lucilej/AutonomousLyre/README.md

# Autonomous Lyre
Projet : créer un support permettant de jouer des mélodies sur la lyre grâce à arduino
