lucilej/AutonomousLyre/RapportsSeances/Seance5.md

<h1>Rapport de la séance 5 du 1er fevrier 2023</h1>
<ul>
  <li><p>J'ai collé avec le pistolet à colle des médiators pour guitare sur les "helices" du servomoteur.</p></li>
  mediators collés
  <li><p>J'ai testé si les médiators marchaient bien sur les cordes.</p></li>
  <li><p>J'ai découpé quatres planches en bois : 2 planches qui vont soutenir sur le côté les planches des moteurs, 2 planches qui font des calepins pour pouvoir visser les autres planches.<p></li>
  <li><p>Je les ai assemblées<p></li>
  <li><p>J'ai fait un mini programme censé faire jouer toutes les cordes de la lyre<p></li>
