lucilej/AutonomousLyre/RapportsSeances/Seance1.md

<h1>Rapport de la séance 1 du 14 décembre 2022</h1>
<ul>
  <li><p>J'ai réfléchi sur quel type de support la lyre pourrait tenir, ainsi que les servomoteurs</p></li>
  <li><p>Réalisation d'un schéma illustrant la lyre et le support qui tient les servomoteurs</p></li>
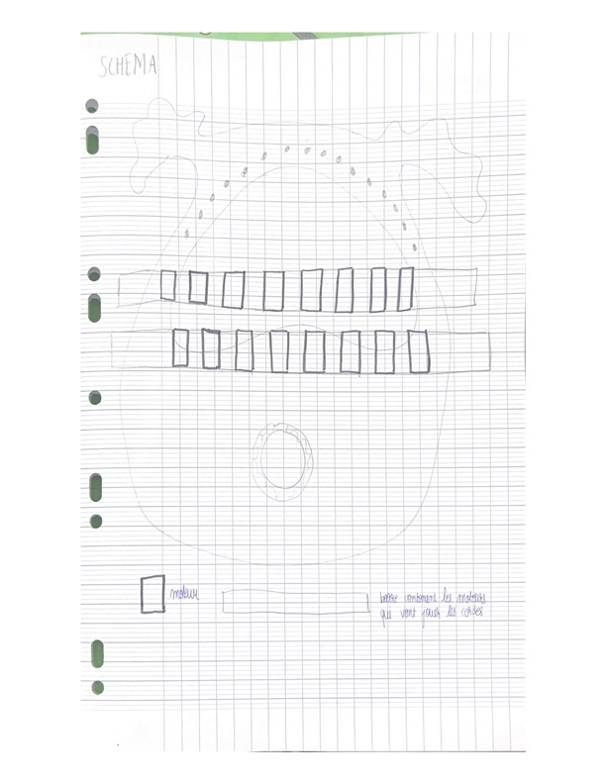
[picture p4: Documents/Images/schemalyre.jpg]
Schema
  
  <li><p>Choix moteur correspondant le mieux au pincement des cordes</p></li>
  <li><p>J'ai lu le cours disponible sur les servomoteurs en faisant un petit montage pour voir comment cela fonctionne</p></li>
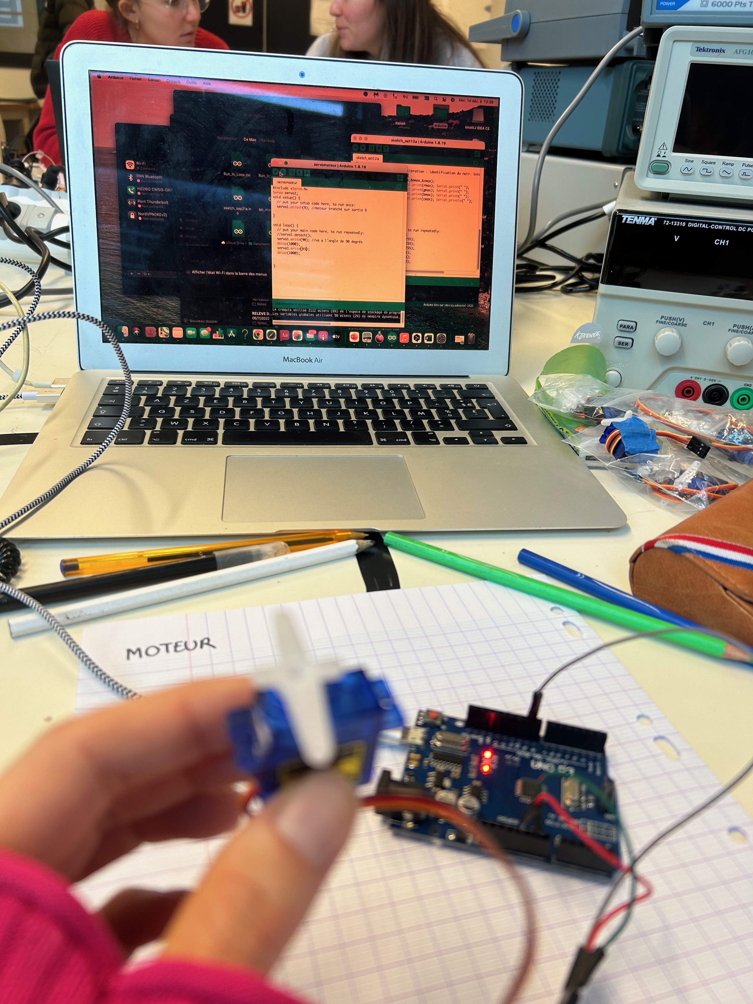
[picture p5: Documents/Images/IMG_0251.jpeg]
Montage d'un servomoteur
