lucilej/AutonomousLyre/Documents/CahierDesCharges.md

<h1>Cahier des charges</h1>
  <ol> 
    <li><p>Contexte et présentation du projet : <p></li>
      <p>Création d'un prototype permettant de jouer de la lyre avec arduino</p>
    <li><p> Besoins et contraintes liés au projet : </p></li>
        <ul>
          <li><p>Contraintes : organiser et comprendre la création du prototype (matériaux, code, assemblage), respecter le planning</p></li>
          <li><p>Besoins : être à l'aise avec les fonctionnalités d'arduino et l'assemblage de pièces</p></li>
        </ul>
    <li><p>Résultats attendus : </p></li>
            <p>Quand on appuie sur un ou des boutons, cela envoie des informations à la carte arduino qui va permettre au moteur de faire fonctionner le prototype en jouant les cordes voulues, et donc la mélodie souhaitée</p>
  </ol>
