lucilej/AutonomousLyre/Documents/PlanningProjet.md

<h1>Planning du projet</h1>
    <h2>Séance 1</h2>
    <ul>
      <li>Imagination d'une maquette pour permettre de mieux se représenter le projet</li>
      <li>Réfléchir sur quelles pièces je pourrais avoir besoin afin de réliser le projet</li>
      <li>Faire un schéma de fonctionnement du projet</li>
      <li>Mieux organiser le github pour les prochaines séances à venir</li>
    </ul>
    <h2>Séance 2</h2>
    <ul>
      <li>Commander le matériel nécessaire au projet</li>
      <li>Créer un support qui maintient l'instrument fermement en place </li>
      <li>Familiarisation avec la bibliothèque MIDI</li>
    </ul>
    <h2>Séance 3</h2>
    <ul>
      <li>Fonctionnement d'un servo moteur</li>
      <li>Début d'un code simple qui permettrait de faire jouer des notes</li>
    </ul>
    <h2>Séance 4</h2>
    <ul>
      <li>Continuer un code</li>
    </ul>
    <h2>Séance 5</h2>
    <ul>
      <li>Assemblage de certaines pièces ou tester un programme</li>
    </ul>
    <h2>Séance 6</h2>
    <ul>
      <li>Code</li>
      <li>Assemblage</li>
    </ul>
    <h2>Séance 7</h2>
    <ul>
      <li>Fin assemblage</li>
      <li>Fin du code</li>
    </ul>
    <h2>Séance 8</h2>
    <ul>
      <li>Retouches et vérification que tout fonctionne</li>
