lucilej/AutonomousLyre/RapportsSeances/Seance7.md

<h1>Rapport de la séance 7 du 15 février 2023</h1>
<ul>
  <li><p>Avant le début du cours, j'ai rectifié les angles de tous les servomoteurs afin qu'ils jouent tous leur corde. A cause de l'instabilité du support et des déplacements vers Polytech j'ai du tout rectifié pendant la séance. Il est arrivé que 1 ou 2 médiators se soient décollés lorsque j'ai joué les cordes car ils n'étaient pas assez bien positionnés. Pour remédier à tous ces problèmes, j'ai coupé les bouts de certains médiators et recollé d'autres pour qu'ils soient parfaitement positionnés devant les cordes. </p></li>
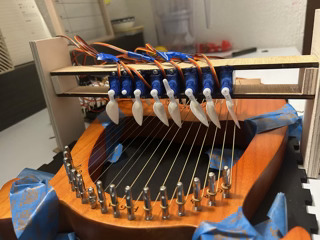
[picture p10: Documents/Images/support.jpg]
support
  
  <li><p>J'ai fixé le support à la grande planche qui tient ma lyre avec de la colle à bois pour que le support reste plus stable. Or après les cours, elle s'est décollée légèrement.<p></li>
  <li><p>Ma plaquette de branchement étant plus grande que je n'en ai besoin, donc Monieur Masson m'a fourni une mini plaquette me permettant de brancher seulement au 0 et 5, que j'ai du construire en soudant.</p></li>
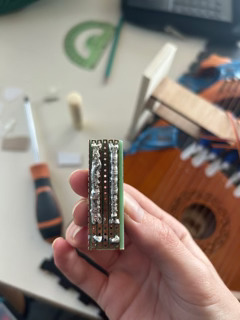
[picture p11: Documents/Images/soudure.jpg]
Soudure plaquette
  
  <li><p>Cette plaquette et la  plaque arduino seront fixés sur le côté droit de mon support, à la verticale. </p></li>
  <li><p>Pendant les vacances, il faudrait que je m'assure que tous les médiators soient bien fixés et jouent encore toutes les cordes, que je programme et utilise le protocole MIDI avec un logiciel afin de pouvoir jouer de la musique, que je refixe le support et la lyre afin que TOUT soit stable. <p></li>
