lucilej/AutonomousLyre/RapportsSeances/Seance6.md

<h1>Rapport de la séance 6 du 8 février 2023</h1>
<ul>
  <li><p>Avant le début du cours, j'ai vissé les deux planches restantes qui servent à soutenir le support des moteurs.</p></li>
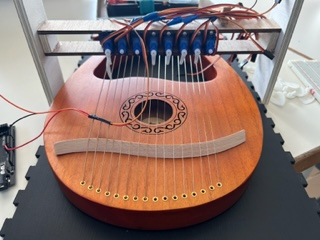
[picture p12: Documents/Images/IMG_1584.jpg]
support
  
  <li><p>J'ai essayé de trouver un bon placement de la lyre sur la planche de sorte à ce que tous les moteurs aient une place qui leur permette de jouer une corde<p></li>
  <li><p>Mon support est un peu plus bas qu'il ne fallait donc j'ai mis des bouts fins de cartons afin que les médiators soient mieux positionnés devant leur corde.<p></li>
  <li><p>J'ai étudié chaque moteur un par un pour savoir à quel angle il est mieux de les faire jouer, les mesures sont différentes pour certains moteurs.</p></li>
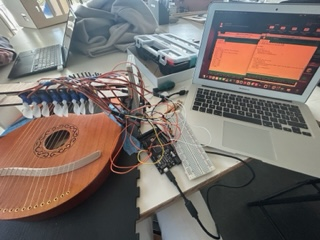
[picture p13: Documents/Images/IMG_1589.jpg]
support et rectification des angles
  
  <li><p>J'ai essayé de faire jouer tous les moteurs situés à l'avant de la lyre, parfois certains moteurs jouaient mal ou la corde d'à côté. 2 moteurs ont arrêté de tourner après plusieurs essais. </p></li>
  <li><p>D'ici la prochaine séance il faudrait que je rectifie certains angles et quelques médiators, de sorte à ce que tous les moteurs jouent normalement les cordes<p></li>
