lucilej/AutonomousLyre/RapportsSeances/Seance4.md

<h1>Rapport de la séance 4 du 18 janvier 2022</h1>
<ul>
  <li><p>On m'a fournit des nouveaux moteurs pour le reste des cordes.</p></li>
  <li>Je les ai vissés à la première planche, puis j'ai rajouté la deuxième sur laquelle j'ai vissé également tous les moteurs. Il reste à stabiliser la lyre sur la grande planche puis attacher les mini planches et moteurs à la grande planche à l'aide d'autres planche en bois.</p></li>
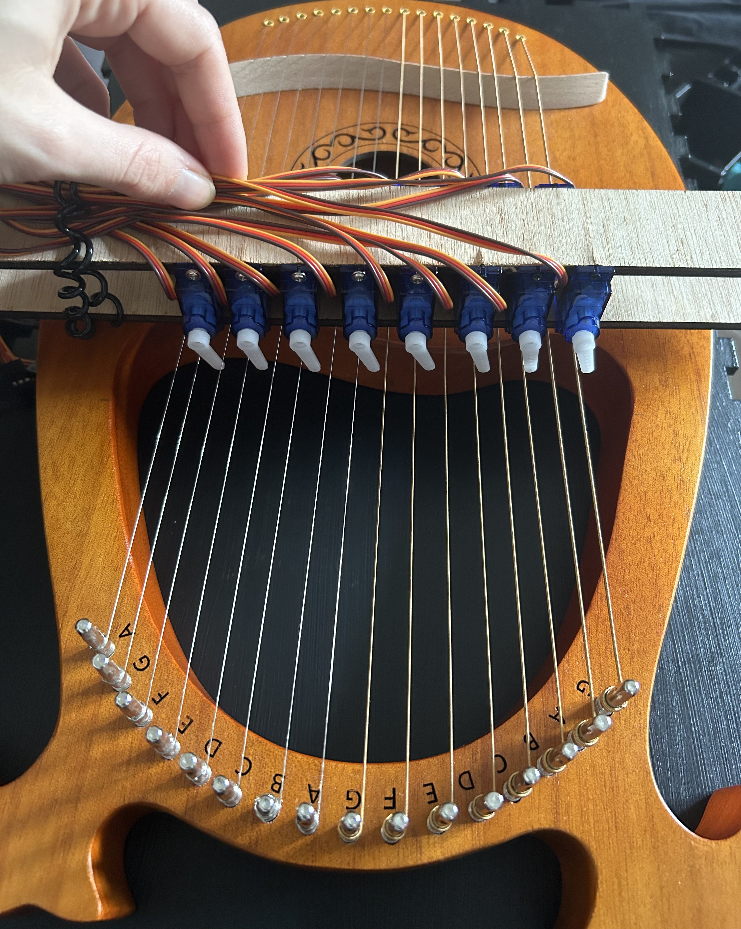
[picture p14: Documents/Images/D673200F-512D-4F54-9E33-8174815A458E.jpeg]
Planches et moteurs
  
  <li><p>Petite présentation orale sur l'avancement du projet aux professeurs.</p></li>
