lucilej/AutonomousLyre/RapportsSeances/Seance3.md

<h1>Rapport de la séance 3 du 11 janvier 2023</h1>
<ul>
  <li><p>J'ai vissé des moteurs aux planches découpées à la séance précédente</p></li>
Moteurs vissés aux planches
  
  <li><p>Pour le problème des fils qui empechent la deuxieme planche d'être vissée, je ferai des trous dans la planche afin de les faire sortir par là pour que la planche soit vissée aux moteurs comme l'autre. Je le ferai lorsque j'aurai tous les moteurs sinon cela me gênera pour visser les autres moteurs.</p></li>
  <li><p>J'ai écrit un programme qui actionne tous les moteurs.</p></li>
Programme qui actionne les moteurs
  
  <li><p> J'ai cherché des informations sur comment fonctionne la bibliothèque midi et lu des tutoriels.</li></p>
