lucilej/AutonomousLyre/RapportsSeances/Seance2.md

<h1>Rapport de la séance 2 du 4 janvier 2023</h1>
<ul>
  <li><p>J'ai réfléchi sur 2 supports différents pour faire tenir les servomoteurs : un en 3D(avec OnShape) et un en 2D ( avec Inkscape)</p></li>
  <li><p>C'est beaucoup plus simple et plus rapide d'adopter le support fait en 2D sur Inkscape. Il s'agit simplement de 2 planches en bois qui vont venir stabiliser les moteurs par le haut et le bas. Les moteurs seront vissés aux planches.</p></li>
  <li><p>Découpage des planches</p></li>
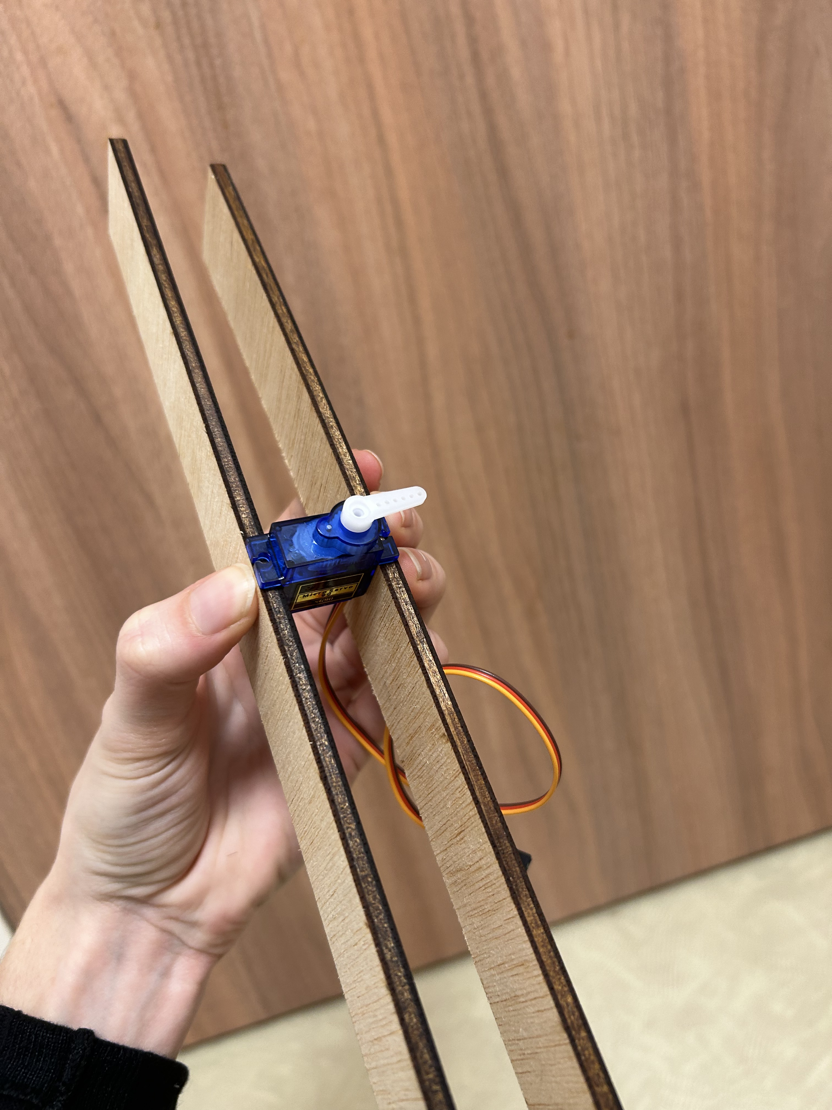
[picture p17: Documents/Images/522CCE30-E549-40A7-87B8-F25D60339723.jpeg]
Planches decoupées
  
  <li><p> Inconvénient : certains fils derangeront la mise en place des planches </li></p>
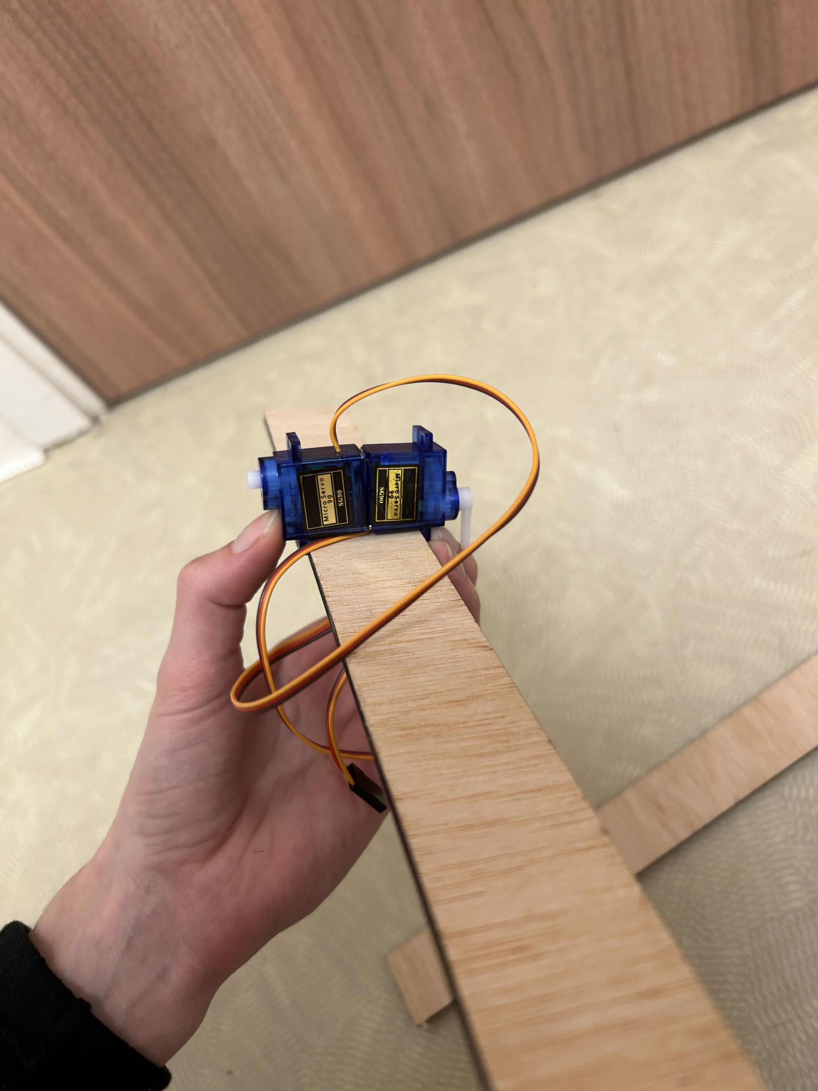
[picture p18: Documents/Images/E310BFAB-3FF7-468D-B122-07361BDE5D95.jpeg]
Inconvénient planches
