lucilej/AutonomousLyre/Documents/Images/IMG_1872.jpg

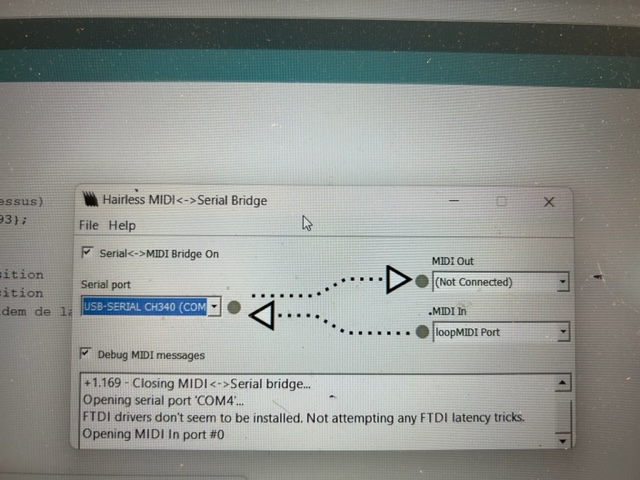
Documents/Images/IMG_1872.jpg
