lucilej/AutonomousLyre/Documents/Images/C6950043-85E8-44F3-B17B-DB1B9945C449.jpeg

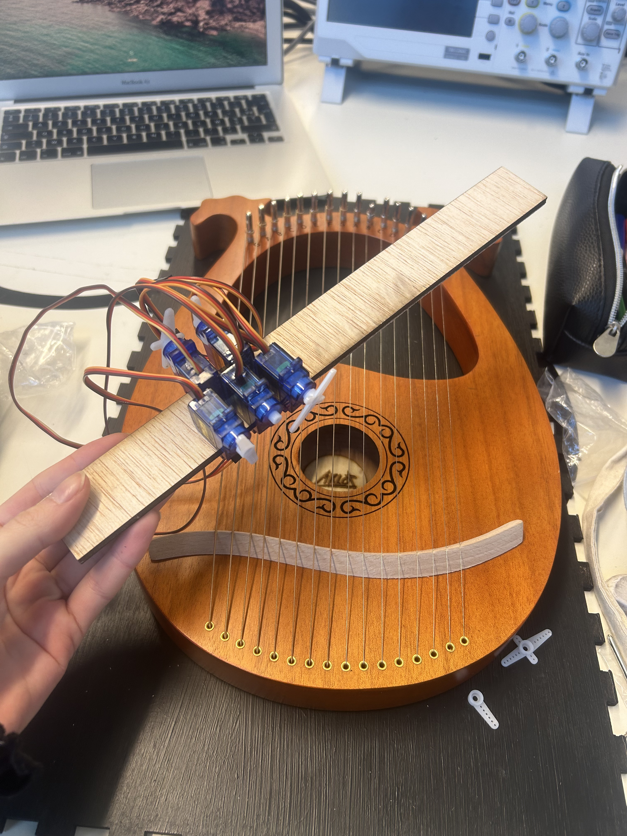
[picture p15: Documents/Images/C6950043-85E8-44F3-B17B-DB1B9945C449.jpeg]
Documents/Images/C6950043-85E8-44F3-B17B-DB1B9945C449.jpeg
