lucilej/AutonomousLyre/Documents/Images/9CC3201F-3050-4836-8916-77AF32211CC8.jpeg

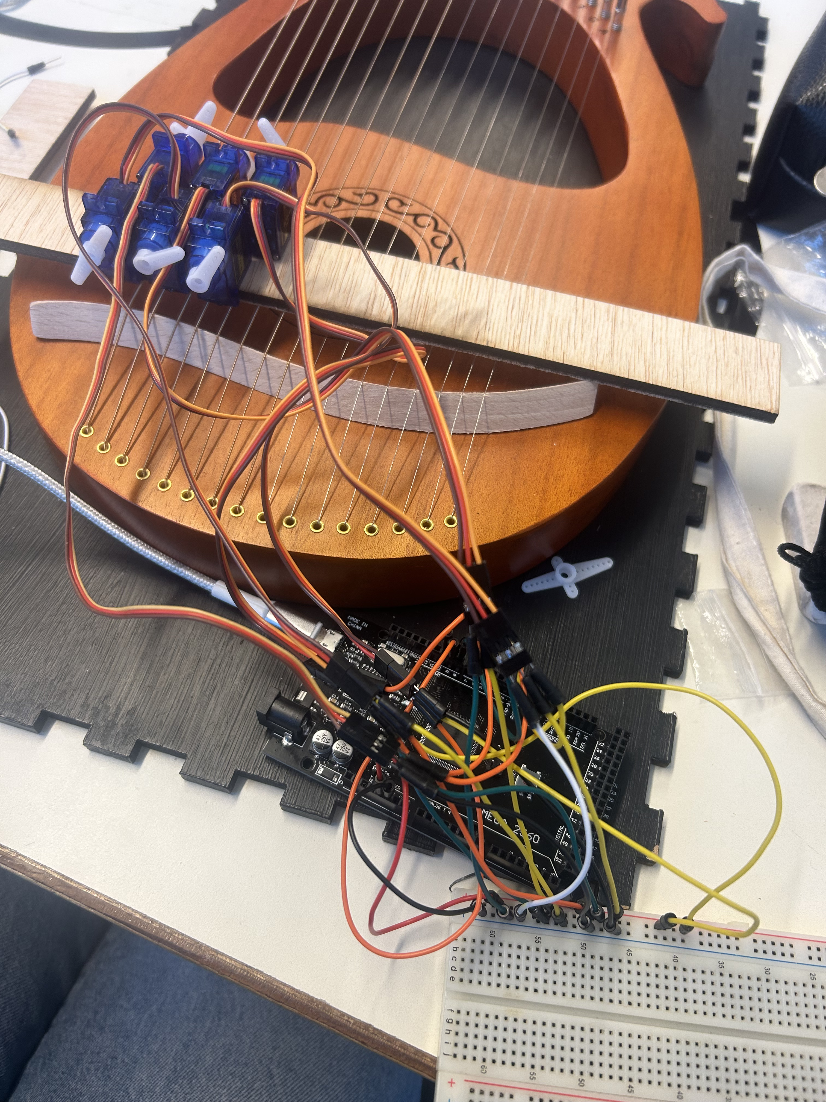
[picture p16: Documents/Images/9CC3201F-3050-4836-8916-77AF32211CC8.jpeg]
Documents/Images/9CC3201F-3050-4836-8916-77AF32211CC8.jpeg
